gesture-Pi/Gesture-recognition-sysytem/(notices)

Notices in the files:
modules/Gesture-STM32/SYSTEM/usart/usart.h:
Copyright(C) ¹ãÖÝÊÐÐÇÒíµç×Ó¿Æ¼¼ÓÐÏÞ¹«Ë¾ 2009-2019
All rights reserved
